CXI9966/RM2025-PowerControlBoard-WirelessCharging/PowerControl_PCM_V0.1_Control/PowerControl_PCM_V0.1_Control.kicad_pcb

## KiCad design PowerControl_PCM_V0.1_Control/PowerControl_PCM_V0.1_Control.kicad_pcb (2026-10-14)

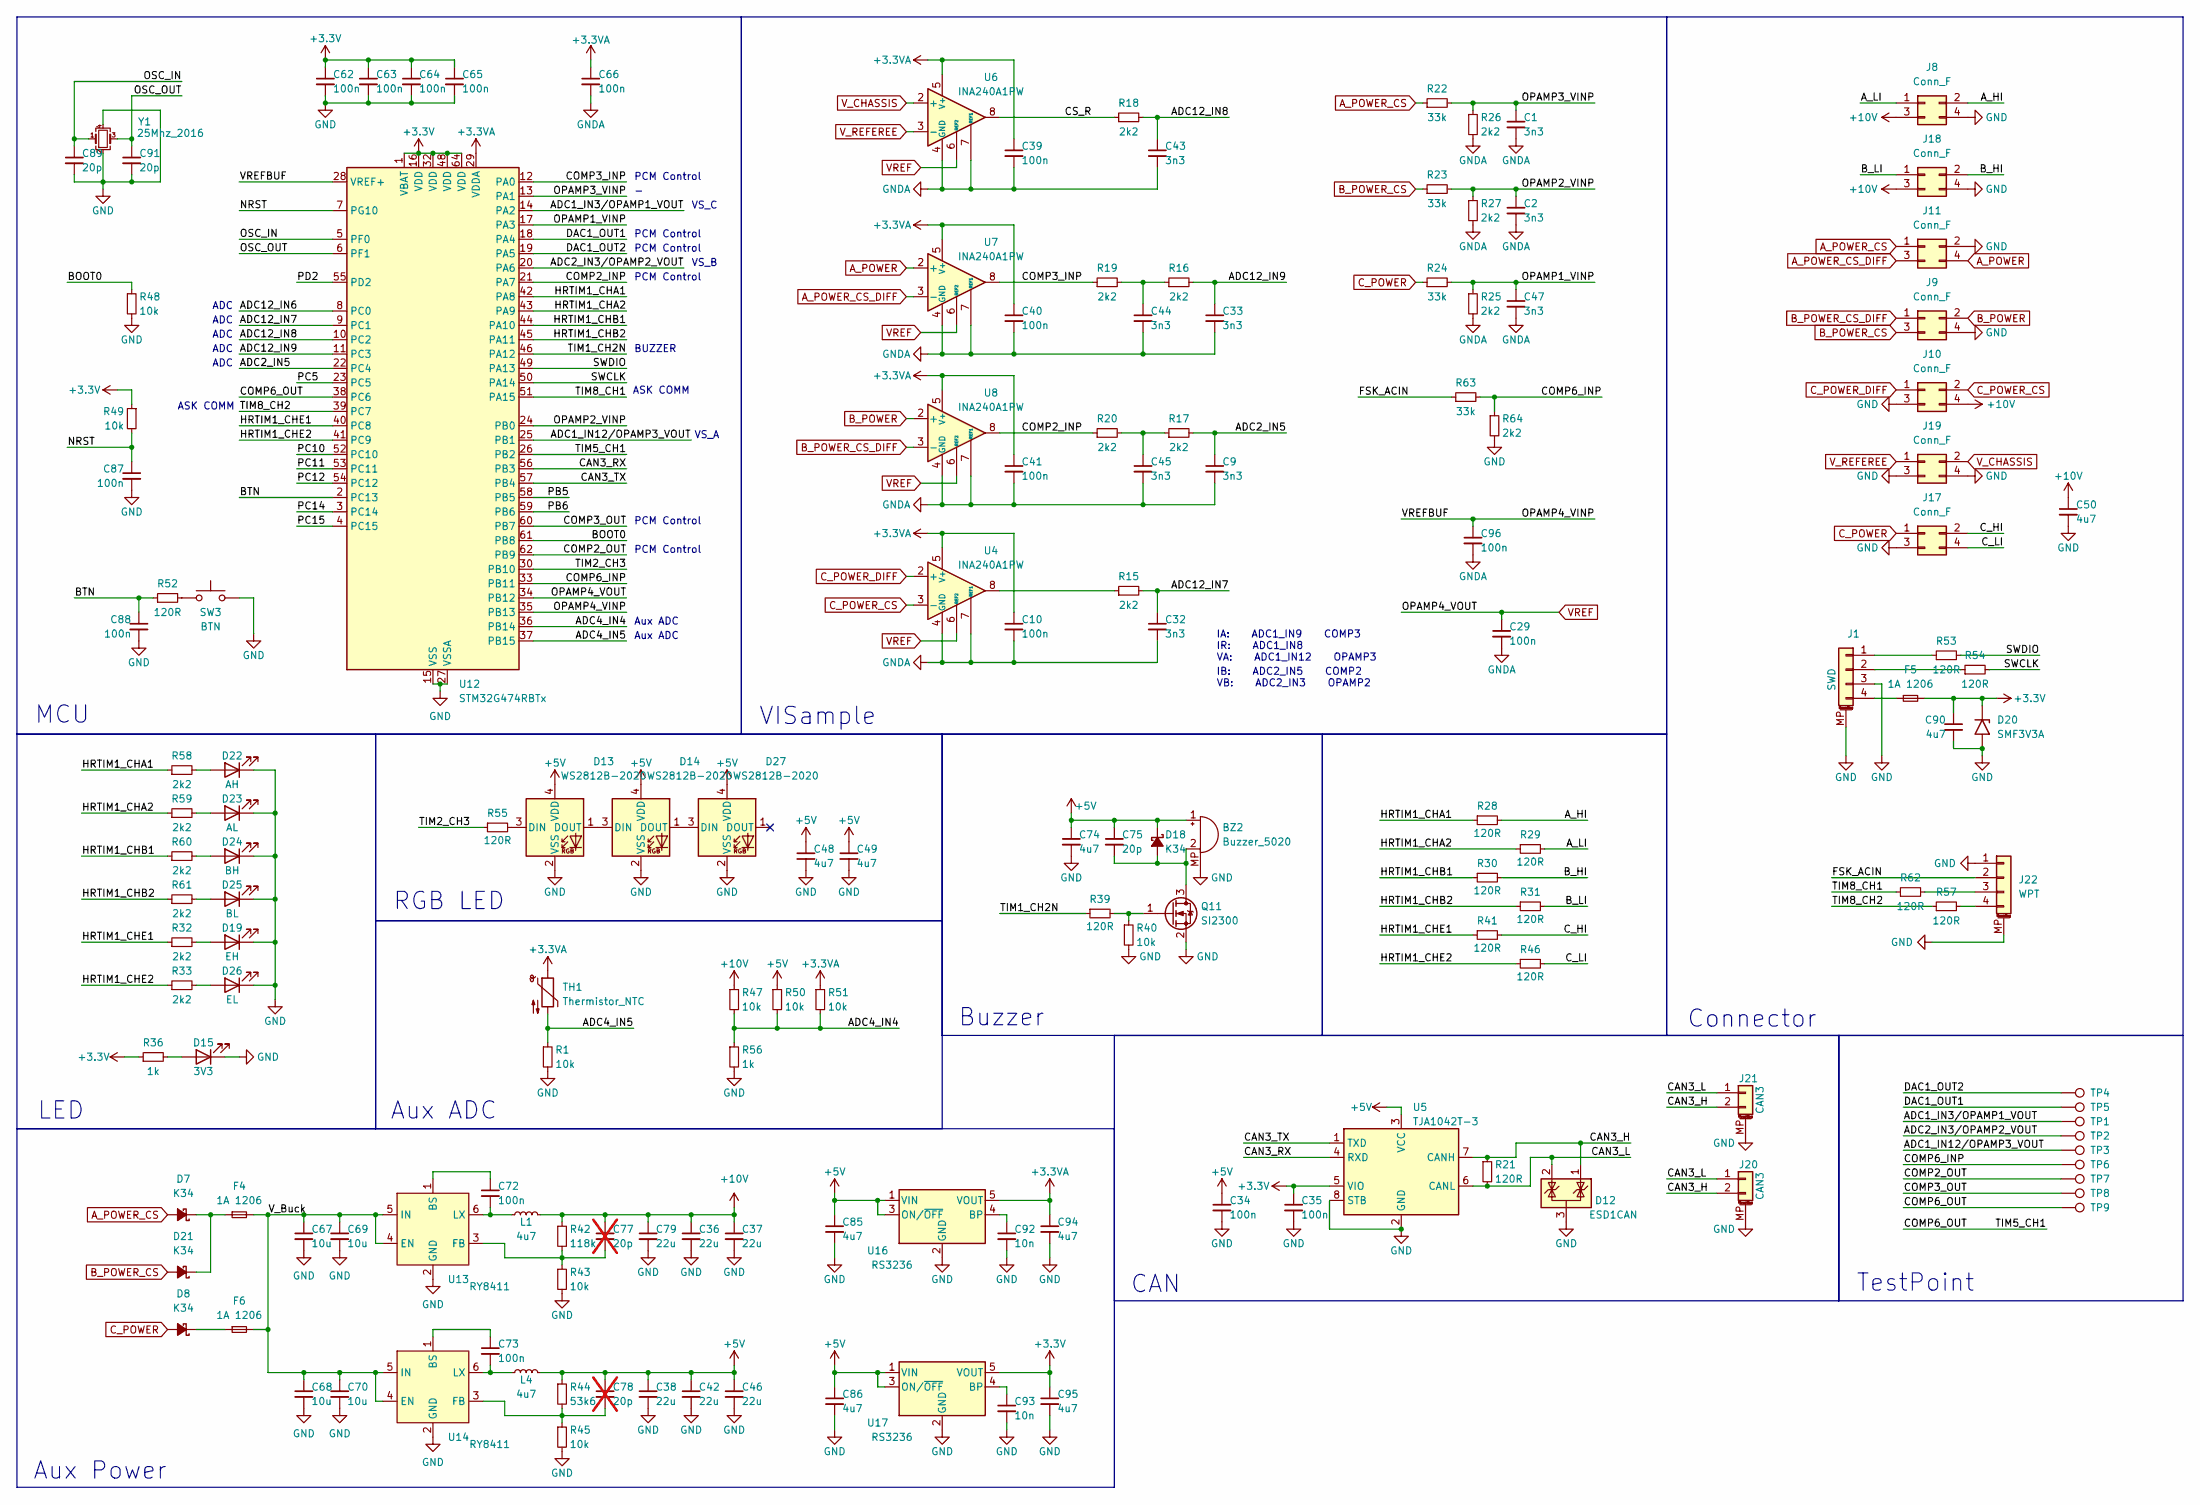
[picture p1: schematic PowerControl_PCM_V0.1_Control.kicad_sch]

Parts:
BZ2: Buzzer_5020
C1, C2, C9, C32, C33, C43, C44, C45, C47: 3n3; C_0603_1608Metric
C10, C29, C34, C35, C39, C40, C41, C62, C63, C64, C65, C66, C72, C73, C87, C88, C96: 100n; C_0603_1608Metric
C36, C37, C38, C42, C46, C79: 22u; C_0805_2012Metric
C48, C49, C50, C74, C85, C86, C90, C94, C95: 4u7; C_0603_1608Metric
C67, C68, C69, C70: 10u; C_1206_3216Metric
C75, C89, C91: 20p; C_0603_1608Metric
C77, C78: 20p; C_0603_1608Metric; not fitted
C92, C93: 10n; C_0603_1608Metric
D7, D8, D18, D21: K34; D_SMF
D12: ESD1CAN; SOT-23
D13, D14, D27: WS2812B-2020
D15: 3V3; LED_0603_1608Metric
D19: EH; LED_0603_1608Metric
D20: SMF3V3A; D_SMF
D22: AH; LED_0603_1608Metric
D23: AL; LED_0603_1608Metric
D24: BH; LED_0603_1608Metric
D25: BL; LED_0603_1608Metric
D26: EL; LED_0603_1608Metric
F4, F5, F6: 1A 1206; Fuse_1206_3216Metric
J1: SWD; Molex_PicoBlade_53261-0471_1x04-1MP_P1.25mm_Horizontal
J8, J9, J10, J11, J17, J18, J19: Conn_F; PinSocket_2x02_P2.00mm
J20, J21: CAN3; JST_GH_BM02B-GHS-TBT_1x02-1MP_P1.25mm_Vertical
J22: WPT; JST_GH_BM04B-GHS-TBT_1x04-1MP_P1.25mm_Vertical
L1, L4: 4u7; L_Sunlord_SWPA3015S
Q11: SI2300; SOT-23
R1, R40, R43, R45, R47, R48, R49, R50, R51: 10k; R_0603_1608Metric
R15, R16, R17, R18, R19, R20, R25, R26, R27, R32, R33, R58, R59, R60, R61, R64: 2k2; R_0603_1608Metric
R21, R28, R29, R30, R31, R39, R41, R46, R52, R53, R54, R55, R57, R62: 120R; R_0603_1608Metric
R22, R23, R24, R63: 33k; R_0603_1608Metric
R36, R56: 1k; R_0603_1608Metric
R42: 118k; R_0603_1608Metric
R44: 53k6; R_0603_1608Metric
SW3: BTN; Button_PTS810
TH1: Thermistor_NTC; R_0603_1608Metric
TP1, TP2, TP3, TP4, TP5, TP6, TP7, TP8, TP9: TestPoint; TestPoint_Pad_D1.0mm
U4, U6, U7, U8: INA240A1PW; TSSOP-8_4.4x3mm_P0.65mm
U5: TJA1042T-3; SOIC-8_3.9x4.9mm_P1.27mm
U12: STM32G474RBTx; LQFP-64_10x10mm_P0.5mm
U13, U14: RY8411; SOT-23-6
U16, U17: RS3236; SOT-23-5
Y1: 25Mhz_2016; Crystal_SMD_2016

Connections:
+3.3V: C35.1, C62.1, C63.1, C64.1, C65.1, C90.1, C95.1, D20.1 (A1), F5.2, R36.1, R49.1, U5.5 (VIO), U12.1 (VBAT), U12.16 (VDD), U12.32 (VDD), U12.48 (VDD), U12.64 (VDD), U17.5 (VOUT)
+3.3VA: C10.1, C39.1, C40.1, C41.1, C66.1, C94.1, R51.1, TH1.1, U4.5 (V+), U6.5 (V+), U7.5 (V+), U8.5 (V+), U12.29 (VDDA), U16.5 (VOUT)
+5V: BZ2.1 (+), C34.1, C38.1, C42.1, C46.1, C48.1, C49.1, C74.1, C75.1, C78.1, C85.1, C86.1, D13.4 (VDD), D14.4 (VDD), D18.1 (K), D27.4 (VDD), L4.2, R44.1, R50.1, U5.3 (VCC), U16.1 (VIN), U16.3 (ON/~OFF), U17.1 (VIN), U17.3 (ON/~OFF)
+10V: C36.1, C37.1, C50.1, C77.1, C79.1, J8.3, J10.4, J18.3, L1.2, R42.1, R47.1
/ADC1_IN3/OPAMP1_VOUT: TP1.1, U12.14 (PA2)
/ADC1_IN12/OPAMP3_VOUT: TP3.1, U12.25 (PB1)
/ADC2_IN3/OPAMP2_VOUT: TP2.1, U12.20 (PA6)
/ADC2_IN5: C9.1, R17.2, U12.22 (PC4)
/ADC4_IN4: R47.2, R50.2, R51.2, R56.1, U12.36 (PB14)
/ADC4_IN5: R1.1, TH1.2, U12.37 (PB15)
/ADC12_IN6: U12.8 (PC0)
/ADC12_IN7: C32.1, R15.2, U12.9 (PC1)
/ADC12_IN8: C43.1, R18.2, U12.10 (PC2)
/ADC12_IN9: C33.1, R16.2, U12.11 (PC3)
/A_HI: J8.2, R28.2
/A_LI: J8.1, R29.2
/BOOT0: R48.1, U12.61 (PB8)
/BTN: C88.1, R52.1, U12.2 (PC13)
/B_HI: J18.2, R30.2
/B_LI: J18.1, R31.2
/CAN3_H: D12.1 (K), J20.2, J21.2, R21.1, U5.7 (CANH)
/CAN3_L: D12.2 (K), J20.1, J21.1, R21.2, U5.6 (CANL)
/CAN3_RX: U5.4 (RXD), U12.56 (PB3)
/CAN3_TX: U5.1 (TXD), U12.57 (PB4)
/COMP2_INP: R20.1, U8.8, U12.21 (PA7)
/COMP2_OUT: TP7.1, U12.62 (PB9)
/COMP3_INP: R19.1, U7.8, U12.12 (PA0)
/COMP3_OUT: TP8.1, U12.60 (PB7)
/COMP6_INP: R63.2, R64.1, TP6.1, U12.33 (PB11)
/COMP6_OUT: TP9.1, U12.26 (PB2), U12.38 (PC6)
/CS_R: R18.1, U6.8
/C_HI: J17.2, R41.2
/C_LI: J17.4, R46.2
/DAC1_OUT1: TP5.1, U12.18 (PA4)
/DAC1_OUT2: TP4.1, U12.19 (PA5)
/FSK_ACIN: J22.2, R63.1
/HRTIM1_CHA1: R28.1, R58.1, U12.42 (PA8)
/HRTIM1_CHA2: R29.1, R59.1, U12.43 (PA9)
/HRTIM1_CHB1: R30.1, R60.1, U12.44 (PA10)
/HRTIM1_CHB2: R31.1, R61.1, U12.45 (PA11)
/HRTIM1_CHE1: R32.1, R41.1, U12.40 (PC8)
/HRTIM1_CHE2: R33.1, R46.1, U12.41 (PC9)
/NRST: C87.1, R49.2, U12.7 (PG10)
/OPAMP1_VINP: C47.1, R24.2, R25.1, U12.17 (PA3)
/OPAMP2_VINP: C2.1, R23.2, R27.1, U12.24 (PB0)
/OPAMP3_VINP: C1.1, R22.2, R26.1, U12.13 (PA1)
/OPAMP4_VINP: C96.1, U12.28 (VREF+), U12.35 (PB13)
/OSC_IN: C89.1, U12.5 (PF0), Y1.1
/OSC_OUT: C91.1, U12.6 (PF1), Y1.3
/PB5: U12.58 (PB5)
/PB6: U12.59 (PB6)
/PC5: U12.23 (PC5)
/PC10: U12.52 (PC10)
/PC11: U12.53 (PC11)
/PC12: U12.54 (PC12)
/PC14: U12.3 (PC14)
/PC15: U12.4 (PC15)
/PD2: U12.55 (PD2)
/SWCLK: R54.2, U12.50 (PA14)
/SWDIO: R53.2, U12.49 (PA13)
/TIM1_CH2N: R39.1, U12.46 (PA12)
/TIM2_CH3: R55.1, U12.30 (PB10)
/TIM8_CH1: R62.1, U12.51 (PA15)
/TIM8_CH2: R57.1, U12.39 (PC7)
/V_Buck: C67.1, C68.1, C69.1, C70.1, F4.2, F6.2, U13.4 (EN), U13.5 (IN), U14.4 (EN), U14.5 (IN)
A_POWER: J11.4, U7.2 (+)
A_POWER_CS: D7.2 (A), J11.1, R22.1
A_POWER_CS_DIFF: J11.3, U7.3 (-)
B_POWER: J9.2, U8.2 (+)
B_POWER_CS: D21.2 (A), J9.3, R23.1
B_POWER_CS_DIFF: J9.1, U8.3 (-)
C_POWER: D8.2 (A), J17.1, R24.1
C_POWER_CS: J10.2, U4.3 (-)
C_POWER_DIFF: J10.1, U4.2 (+)
GND: BZ2.MP, C34.2, C35.2, C36.2, C37.2, C38.2, C42.2, C46.2, C48.2, C49.2, C50.2, C62.2, C63.2, C64.2, C65.2, C67.2, C68.2, C69.2, C70.2, C74.2, C79.2, C85.2, C86.2, C87.2, C88.2, C89.2, C90.2, C91.2, C92.2, C93.2, C94.2, C95.2, D12.3 (A), D13.2 (VSS), D14.2 (VSS), D15.1 (K), D19.1 (K), D20.2 (A2), D22.1 (K), D23.1 (K), D24.1 (K), D25.1 (K), D26.1 (K), D27.2 (VSS), J1.3, J1.MP (MountPin), J8.4, J9.4, J10.3, J11.2, J17.3, J18.4, J19.3, J19.4, J20.MP (MountPin), J21.MP (MountPin), J22.1, J22.MP (MountPin), Q11.2 (S), R1.2, R40.2, R43.2, R45.2, R48.2, R56.2, R64.2, SW3.2, U5.2 (GND), U5.8 (STB), U12.15 (VSS), U12.27 (VSSA), U12.31 (VSS), U12.47 (VSS), U12.63 (VSS), U13.2 (GND), U14.2 (GND), U16.2 (GND), U17.2 (GND), Y1.2, Y1.4
GNDA: C1.2, C2.2, C9.2, C10.2, C29.2, C32.2, C33.2, C39.2, C40.2, C41.2, C43.2, C44.2, C45.2, C47.2, C66.2, C96.2, R25.2, R26.2, R27.2, U4.1 (GND), U4.4 (GND), U4.7 (REF1), U6.1 (GND), U6.4 (GND), U6.7 (REF1), U7.1 (GND), U7.4 (GND), U7.7 (REF1), U8.1 (GND), U8.4 (GND), U8.7 (REF1)
unnamed: BZ2.2 (-), C75.2, D18.2 (A), Q11.3 (D)
unnamed: C44.1, R16.1, R19.2
unnamed: C45.1, R17.1, R20.2
unnamed: D8.1 (K), F6.1
unnamed: D13.3 (DIN), R55.2
unnamed: D13.1 (DOUT), D14.3 (DIN)
unnamed: D14.1 (DOUT), D27.3 (DIN)
unnamed: D15.2 (A), R36.2
unnamed: D19.2 (A), R32.2
unnamed: D7.1 (K), D21.1 (K), F4.1
unnamed: D22.2 (A), R58.2
unnamed: D23.2 (A), R59.2
unnamed: D24.2 (A), R60.2
unnamed: D25.2 (A), R61.2
unnamed: D26.2 (A), R33.2
unnamed: J1.1, R53.1
unnamed: J1.2, R54.1
unnamed: F5.1, J1.4
unnamed: J22.3, R62.2
unnamed: J22.4, R57.2
unnamed: Q11.1 (G), R39.2, R40.1
unnamed: R15.1, U4.8
unnamed: R52.2, SW3.1
unnamed: C72.1, U13.1 (BS)
unnamed: C77.2, R42.2, R43.1, U13.3 (FB)
unnamed: C72.2, L1.1, U13.6 (LX)
unnamed: C73.1, U14.1 (BS)
unnamed: C78.2, R44.2, R45.1, U14.3 (FB)
unnamed: C73.2, L4.1, U14.6 (LX)
unnamed: C92.1, U16.4 (BP)
unnamed: C93.1, U17.4 (BP)
VREF: C29.1, U4.6 (REF2), U6.6 (REF2), U7.6 (REF2), U8.6 (REF2), U12.34 (PB12)
V_CHASSIS: J19.2, U6.2 (+)
V_REFEREE: J19.1, U6.3 (-)

Notes on the sheet:
Aux ADC
VS_A
ADC
IA: ADC1_IN9 COMP3 IR: ADC1_IN8 VA: ADC1_IN12 OPAMP3
PCM Control
Buzzer
TestPoint
CAN
Connector
VS_C
BUZZER
VISample
IB: ADC2_IN5 COMP2 VB: ADC2_IN3 OPAMP2
ASK COMM
LED
RGB LED
Aux Power
VS_B
MCU

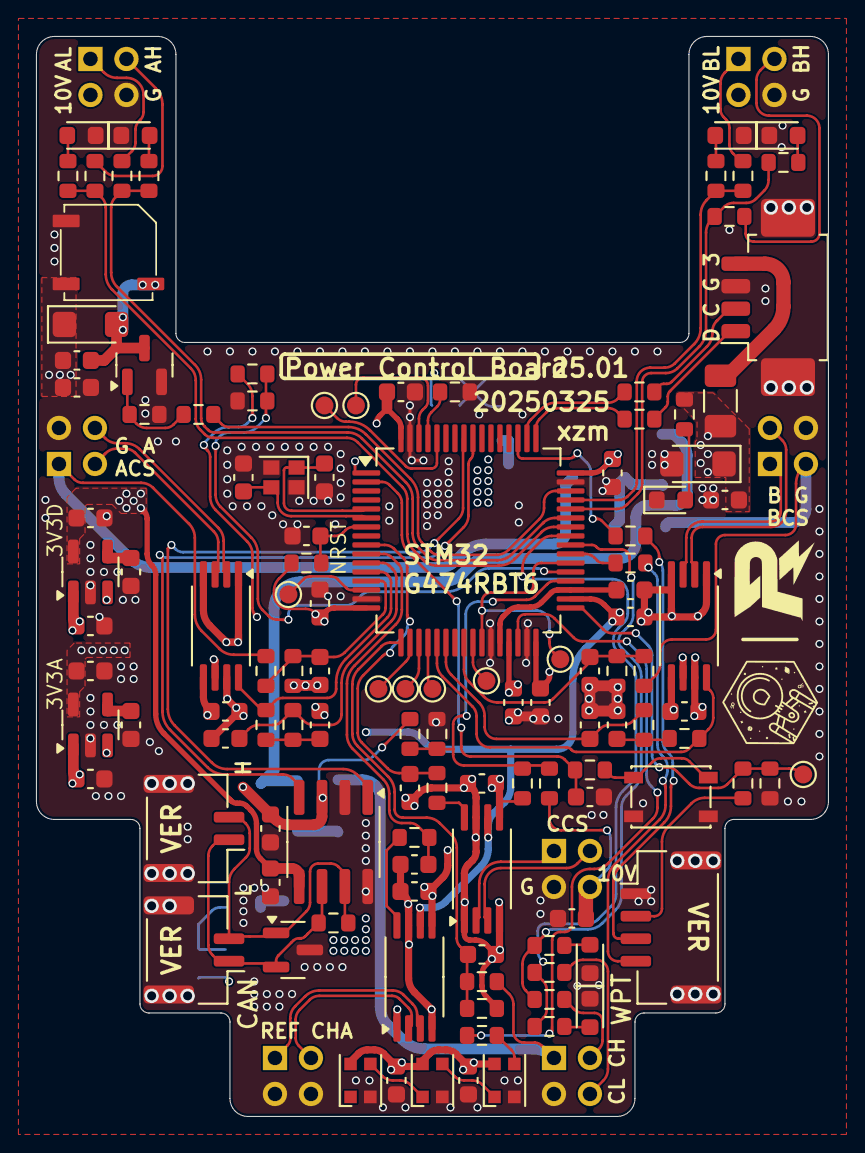
[picture p2: board PowerControl_PCM_V0.1_Control.kicad_pcb from above]

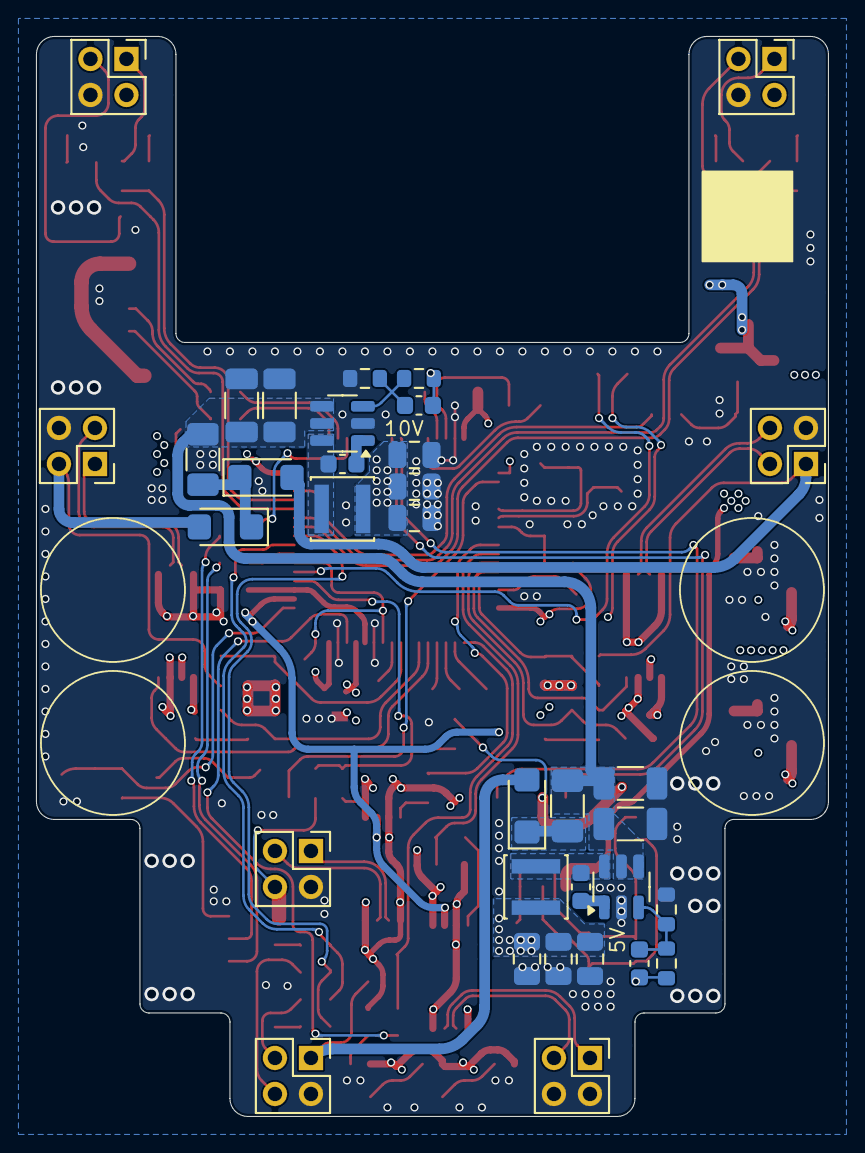
[picture p3: board PowerControl_PCM_V0.1_Control.kicad_pcb from below]

Board: 4 copper layers, 44.0 x 60.0 mm, 155 parts (34 on the bottom side), 100 nets.
