CXI9966/RM2025-PowerControlBoard-WirelessCharging/PowerControl_PCM_V0.1_Power/PowerControl_PCM_V0.1_Power.kicad_pcb

## KiCad design PowerControl_PCM_V0.1_Power/PowerControl_PCM_V0.1_Power.kicad_pcb (2026-10-14)

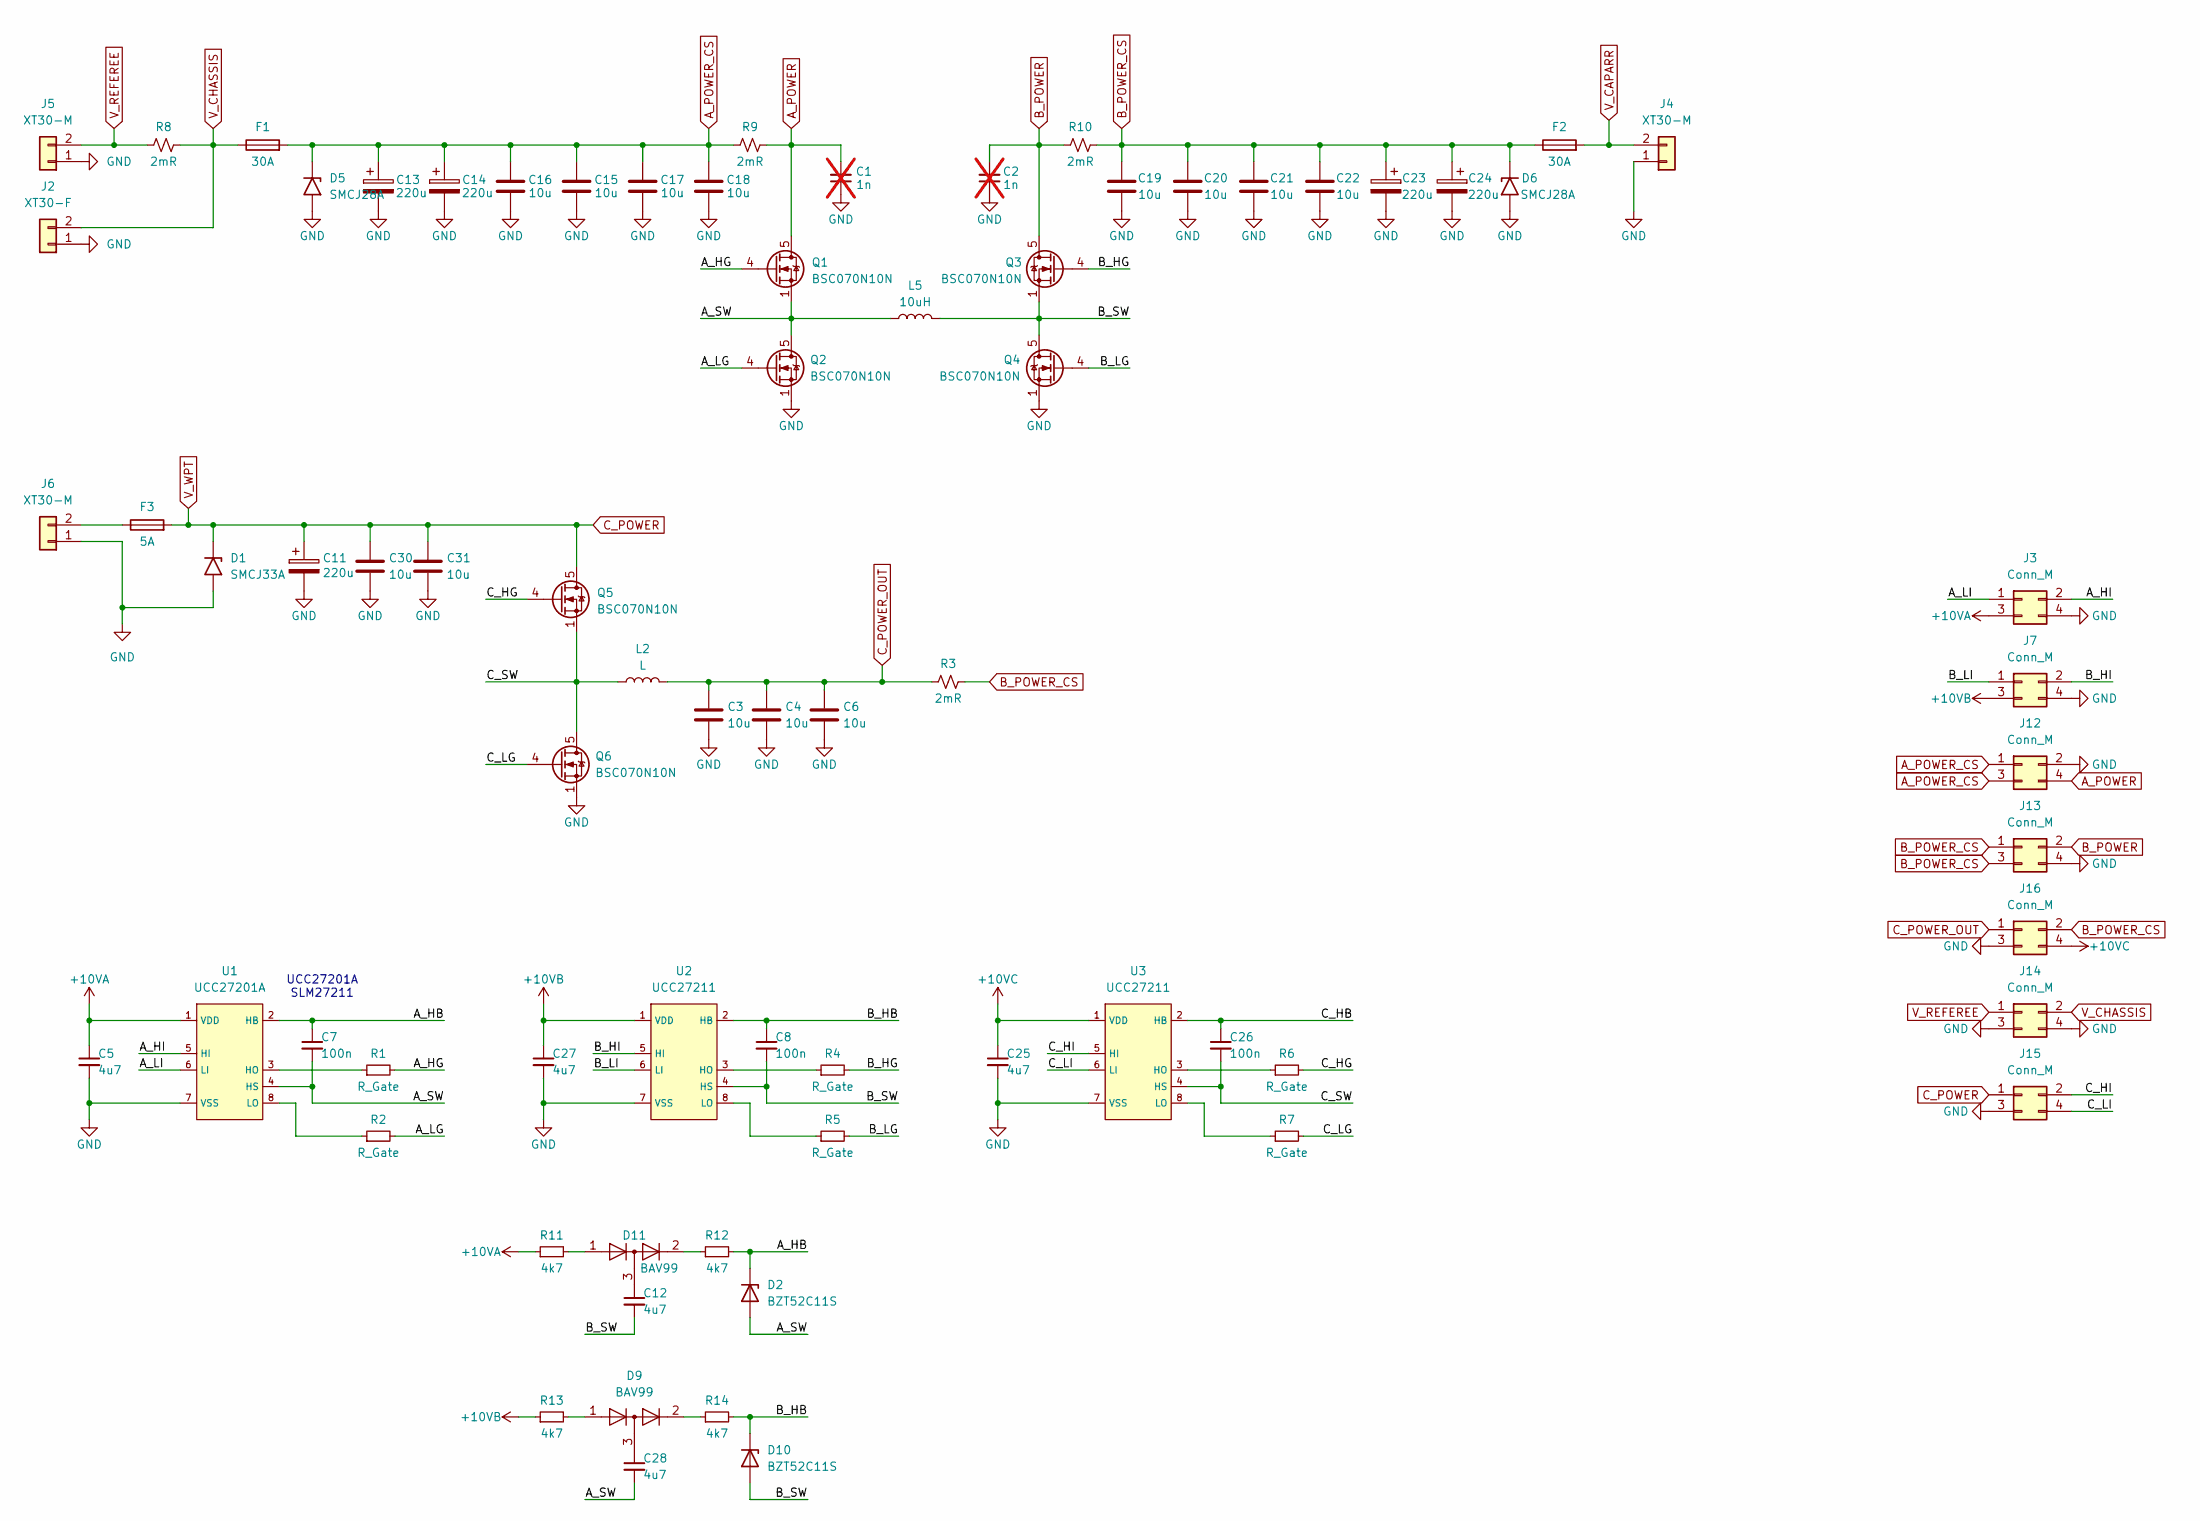
[picture p4: schematic PowerControl_PCM_V0.1_Power.kicad_sch]

Parts:
C1, C2: 1n; C_0603_1608Metric; not fitted
C3, C4, C6, C15, C16, C17, C18, C19, C20, C21, C22, C30, C31: 10u; C_1206_3216Metric
C5, C12, C25, C27, C28: 4u7; C_0603_1608Metric
C7, C8, C26: 100n; C_0603_1608Metric
C11, C13, C14, C23, C24: 220u; C_D8.0mm_P3.50mm
D1: SMCJ33A; D_SMC
D2, D10: BZT52C11S; D_SOD-323_HandSoldering
D5, D6: SMCJ28A; D_SMC
D9, D11: BAV99; SOT-23
F1, F2: 30A; Fuse_Littelfuse-NANO2-451_453
F3: 5A; Fuse_Littelfuse-NANO2-451_453
J2: XT30-F; AMASS_XT30U-F_1x02_P5.0mm_Vertical
J3, J7, J12, J13, J14, J15, J16: Conn_M; PinHeader_2x02_P2.00mm_Vertical_SMD
J4, J5, J6: XT30-M; AMASS_XT30U-M_1x02_P5.0mm_Vertical
L2: L; L_Wuerth_HCI-1040
L5: 10uH; L_VER2923
Q1, Q2, Q3, Q4, Q5, Q6: BSC070N10N; TDSON-8-1
R1, R2, R4, R5, R6, R7: R_Gate; R_0603_1608Metric
R3, R8, R9, R10: 2mR; R_2512_6332Metric
R11, R12, R13, R14: 4k7; R_0603_1608Metric
U1: UCC27201A; SOIC-8_3.9x4.9mm_P1.27mm
U2, U3: UCC27211; SOIC-8_3.9x4.9mm_P1.27mm

Connections:
+10VA: C5.1, J3.3, R11.1, U1.1 (VDD)
+10VB: C27.1, J7.3, R13.1, U2.1 (VDD)
+10VC: C25.1, J16.4, U3.1 (VDD)
/A_HB: C7.1, D2.1 (K), R12.2, U1.2 (HB)
/A_HG: Q1.4 (G), R1.2
/A_HI: J3.2, U1.5 (HI)
/A_LG: Q2.4 (G), R2.2
/A_LI: J3.1, U1.6 (LI)
/A_SW: C7.2, C28.2, D2.2 (A), L5.1, Q1.1 (S), Q1.2 (S), Q1.3 (S), Q2.5 (D), U1.4 (HS)
/B_HB: C8.1, D10.1 (K), R14.2, U2.2 (HB)
/B_HG: Q3.4 (G), R4.2
/B_HI: J7.2, U2.5 (HI)
/B_LG: Q4.4 (G), R5.2
/B_LI: J7.1, U2.6 (LI)
/B_SW: C8.2, C12.2, D10.2 (A), L5.2, Q3.1 (S), Q3.2 (S), Q3.3 (S), Q4.5 (D), U2.4 (HS)
/C_HB: C26.1, U3.2 (HB)
/C_HG: Q5.4 (G), R6.2
/C_HI: J15.2, U3.5 (HI)
/C_LG: Q6.4 (G), R7.2
/C_LI: J15.4, U3.6 (LI)
/C_SW: C26.2, L2.1, Q5.1 (S), Q5.2 (S), Q5.3 (S), Q6.5 (D), U3.4 (HS)
A_POWER: C1.2, J12.4, Q1.5 (D), R9.2
A_POWER_CS: C13.1, C14.1, C15.2, C16.2, C17.2, C18.2, D5.1 (A1), F1.2, J12.1, J12.3, R9.1
B_POWER: C2.2, J13.2, Q3.5 (D), R10.1
B_POWER_CS: C19.2, C20.2, C21.2, C22.2, C23.1, C24.1, D6.1 (A1), F2.1, J13.1, J13.3, J16.2, R3.2, R10.2
C_POWER: C11.1, C30.1, C31.1, D1.1 (A1), F3.2, J15.1, Q5.5 (D)
C_POWER_OUT: C3.1, C4.1, C6.1, J16.1, L2.2, R3.1
GND: C1.1, C2.1, C3.2, C4.2, C5.2, C6.2, C11.2, C13.2, C14.2, C15.1, C16.1, C17.1, C18.1, C19.1, C20.1, C21.1, C22.1, C23.2, C24.2, C25.2, C27.2, C30.2, C31.2, D1.2 (A2), D5.2 (A2), D6.2 (A2), J2.1, J3.4, J4.1, J5.1, J6.1, J7.4, J12.2, J13.4, J14.3, J14.4, J15.3, J16.3, Q2.1 (S), Q2.2 (S), Q2.3 (S), Q4.1 (S), Q4.2 (S), Q4.3 (S), Q6.1 (S), Q6.2 (S), Q6.3 (S), U1.7 (VSS), U2.7 (VSS), U3.7 (VSS)
unnamed: C12.1, D11.3 (K)
unnamed: C28.1, D9.3 (K)
unnamed: D9.2 (A), R14.1
unnamed: D9.1 (K), R13.2
unnamed: D11.2 (A), R12.1
unnamed: D11.1 (K), R11.2
unnamed: F3.1, J6.2
unnamed: R1.1, U1.3 (HO)
unnamed: R2.1, U1.8 (LO)
unnamed: R4.1, U2.3 (HO)
unnamed: R5.1, U2.8 (LO)
unnamed: R6.1, U3.3 (HO)
unnamed: R7.1, U3.8 (LO)
V_CAPARR: F2.2, J4.2
V_CHASSIS: F1.1, J2.2, J14.2, R8.2
V_REFEREE: J5.2, J14.1, R8.1

Notes on the sheet:
UCC27201A SLM27211

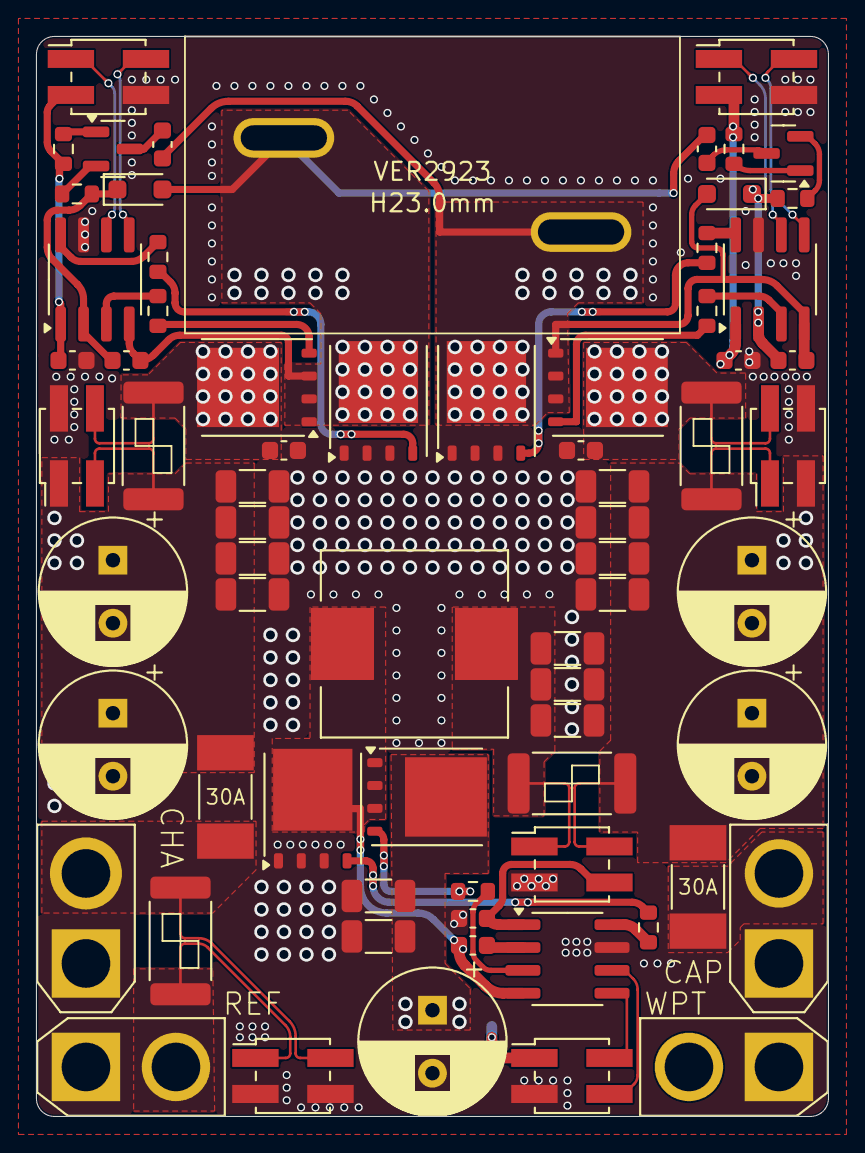
[picture p5: board PowerControl_PCM_V0.1_Power.kicad_pcb from above]

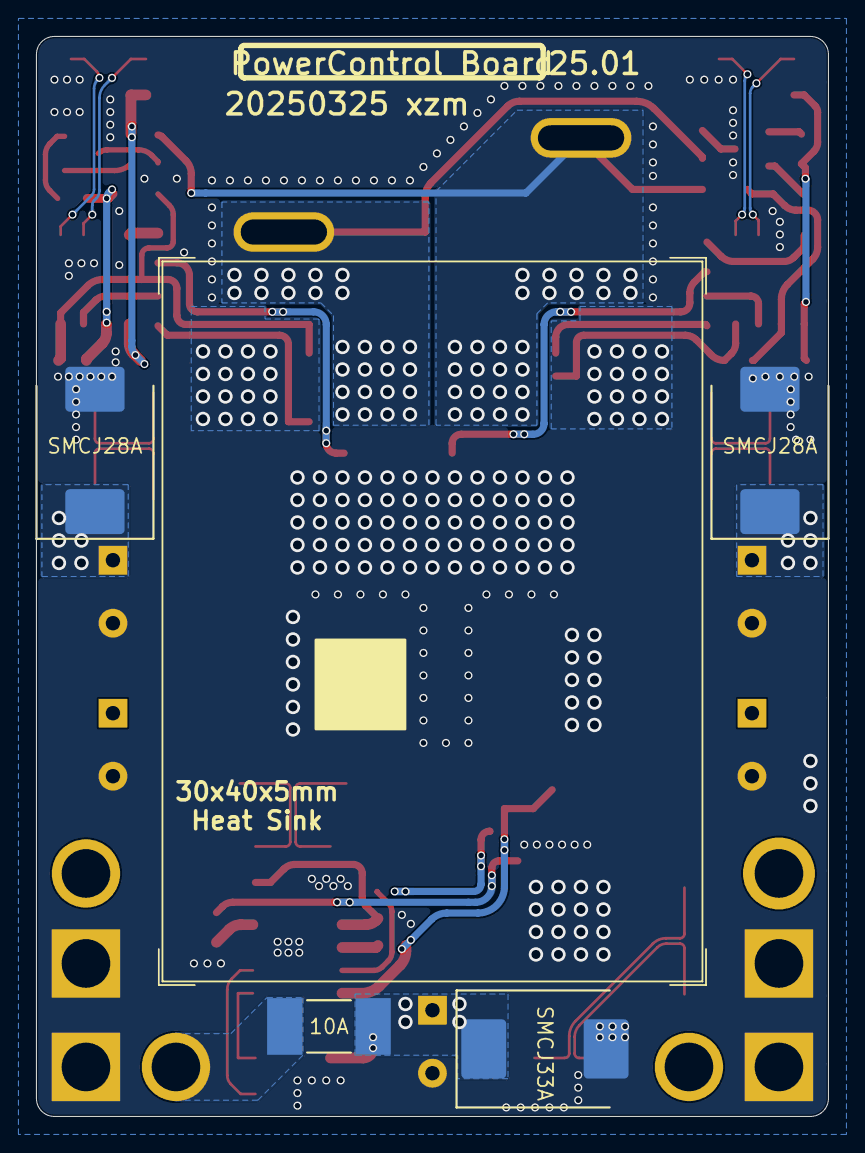
[picture p6: board PowerControl_PCM_V0.1_Power.kicad_pcb from below]

Board: 2 copper layers, 44.0 x 60.0 mm, 74 parts (4 on the bottom side), 44 nets.
