CXI9966/RM2025-PowerControlBoard-WirelessCharging/PowerControlBoard_Software_FieldVersion/Core/Inc/Calibration.hpp

#pragma once
#include "main.h"
//#include "PowerManager.hpp"
//#include "Config.hpp"

#define HARDWARE_ID 502

// CAN standard identifiers used by the field-version protocol.
#define CAN_CMD_ID             0x161U
#define CAN_FEEDBACK_ID        0x151U
#define CAN_FEEDBACK_NEW_ID    0x152U


#ifndef HARDWARE_ID
#error "please specify hardware id"
#endif


//#define WPT_HARDWARE
#define CALIBRATION_MODE
//#define IGNORE_CAPACITOR_ERROR

#ifndef CALIBRATION_MODE




#define HARDWARE_UID_W0 0x03473487
#define HARDWARE_UID_W1 0x1397444617
#define HARDWARE_UID_W2 0x540292914


#define ADC_VA_K        0.00284025493302185f
#define ADC_VA_B        0.096382087f
#define ADC_VB_K        0.00283064245539459f
#define ADC_VB_B        0.096382087f

#define ADC_IA_K        -0.00426032707865977f
#define ADC_IA_B        34.6220566648572f
#define ADC_IB_K        0.00436961348441836f
#define ADC_IB_B        -35.442372697575f

#define ADC_IREF_K      0.00438520650402692f
#define ADC_IREF_B      -35.6851326479174f

#define WPT_HARDWARE
#define ADC_VWPT_K      0.00282862236057022f
#define ADC_VWPT_B      0.126888445762173f
#define ADC_IWPT_K      0.00421074805006724f
#define ADC_IWPT_B      -34.2917170449864f

#elif (HARDWARE_ID == 501) //备用

#define HARDWARE_UID_W0     0x00540049
#define HARDWARE_UID_W1     0x534B5008
#define HARDWARE_UID_W2     0x20343732

#define ADC_VA_K        0.0027260742967763f
#define ADC_VA_B        0.5167775143107710f
#define ADC_VB_K        0.0027839114676537f
#define ADC_VB_B        0.1233551070156690f

#define ADC_IA_K        -0.00426032707865977f
#define ADC_IA_B        34.6220566648572f
#define ADC_IB_K        0.00436961348441836f
#define ADC_IB_B        -35.442372697575f

#define ADC_IREF_K      0.00438520650402692f
#define ADC_IREF_B      -35.6851326479174f

#define WPT_HARDWARE
#define ADC_VWPT_K      0.00282862236057022f
#define ADC_VWPT_B      0.126888445762173f
#define ADC_IWPT_K      0.00421074805006724f
#define ADC_IWPT_B      -34.2917170449864f


#elif (HARDWARE_ID == 502) //备用

#define HARDWARE_UID_W0     0x00550045
#define HARDWARE_UID_W1     0x534B5008
#define HARDWARE_UID_W2     0x20343732

#define ADC_VA_K        0.0027239318140675f
#define ADC_VA_B        0.3552299834552710f
#define ADC_VB_K        0.0027930288554394f
#define ADC_VB_B        0.0890119136534544f

#define ADC_IA_K        -0.00426032707865977f
#define ADC_IA_B        34.6220566648572f
#define ADC_IB_K        0.00436961348441836f
#define ADC_IB_B        -35.442372697575f

#define ADC_IREF_K      0.00438520650402692f
#define ADC_IREF_B      -35.6851326479174f

#define WPT_HARDWARE
#define ADC_VWPT_K      0.0027699952827981f
#define ADC_VWPT_B      0.0915677729711426f
#define ADC_IWPT_K      0.00421074805006724f
#define ADC_IWPT_B      -34.1917170449864f


#elif (HARDWARE_ID == 503) 

#define HARDWARE_UID_W0     0x00540047
#define HARDWARE_UID_W1     0x534B5008
#define HARDWARE_UID_W2     0x20343732

#define ADC_VA_K        0.0028255684147110f
#define ADC_VA_B        0.0660700075102127f
#define ADC_VB_K        0.0028423113464348f
#define ADC_VB_B        0.0901576051061248f

#define ADC_IA_K        -0.00426032707865977f
#define ADC_IA_B        34.6220566648572f
#define ADC_IB_K        0.00436961348441836f
#define ADC_IB_B        -35.442372697575f

#define ADC_IREF_K      0.00438520650402692f
#define ADC_IREF_B      -35.6851326479174f

#define WPT_HARDWARE
#define ADC_VWPT_K      0.0027579227033994f
#define ADC_VWPT_B      0.0733421803892185f
#define ADC_IWPT_K      0.00421074805006724f
#define ADC_IWPT_B      -34.2917170449864f


#elif (HARDWARE_ID == 504) //英雄

#define HARDWARE_UID_W0     0x00550046
#define HARDWARE_UID_W1     0x534B5008
#define HARDWARE_UID_W2     0x20343732

#define ADC_VA_K        0.0027282881375574f
#define ADC_VA_B        0.1831615104370490f
#define ADC_VB_K        0.0028300840292121f
#define ADC_VB_B        0.1077536795506190f

#define ADC_IA_K        -0.00426032707865977f
#define ADC_IA_B        34.6220566648572f
#define ADC_IB_K        0.00436961348441836f
#define ADC_IB_B        -35.442372697575f

#define ADC_IREF_K      0.00438520650402692f
#define ADC_IREF_B      -35.6851326479174f

#define WPT_HARDWARE
#define ADC_VWPT_K      0.0028197687167123f
#define ADC_VWPT_B      0.0609614634376214f
#define ADC_IWPT_K      0.00421074805006724f
#define ADC_IWPT_B      -34.2917170449864f


#elif (HARDWARE_ID == 505) //备用

#define HARDWARE_UID_W0     0x001B0037
#define HARDWARE_UID_W1     0x31365010
#define HARDWARE_UID_W2     0x2035384D

#define ADC_VA_K        0.0027734789141005f
#define ADC_VA_B        0.0927763511337112f
#define ADC_VB_K        0.0028365236221268f
#define ADC_VB_B        0.0812055915390602f

#define ADC_IA_K        -0.00426032707865977f
#define ADC_IA_B        34.6220566648572f
#define ADC_IB_K        0.00436961348441836f
#define ADC_IB_B        -35.442372697575f

#define ADC_IREF_K      0.00438520650402692f
#define ADC_IREF_B      -35.6851326479174f

#define WPT_HARDWARE
#define ADC_VWPT_K      0.0028256477659557f
#define ADC_VWPT_B      0.0641163842218795f
#define ADC_IWPT_K      0.00421074805006724f
#define ADC_IWPT_B      -34.2917170449864f


#elif (HARDWARE_ID == 506) //备用

#define HARDWARE_UID_W0     0x001B002B
#define HARDWARE_UID_W1     0x31365010
#define HARDWARE_UID_W2     0x2035384D

#define ADC_VA_K        0.0028196592091020f
#define ADC_VA_B        0.0926029190696198f
#define ADC_VB_K        0.0028303117276925f
#define ADC_VB_B        0.0869209878046959f

#define ADC_IA_K        -0.00426032707865977f
#define ADC_IA_B        34.6220566648572f
#define ADC_IB_K        0.00436961348441836f
#define ADC_IB_B        -35.442372697575f

#define ADC_IREF_K      0.00438520650402692f
#define ADC_IREF_B      -35.6851326479174f

#define WPT_HARDWARE
#define ADC_VWPT_K      0.0028368950138764f
#define ADC_VWPT_B      0.0808307308422300f
#define ADC_IWPT_K      0.00421074805006724f
#define ADC_IWPT_B      -34.2917170449864f

#elif (HARDWARE_ID == 507) //哨兵

#define HARDWARE_UID_W0     0x001B003F
#define HARDWARE_UID_W1     0x31365010
#define HARDWARE_UID_W2     0x2035384D

#define ADC_VA_K        0.0028280222555144f
#define ADC_VA_B        0.0846544037791155f
#define ADC_VB_K        0.0028143006818382f
#define ADC_VB_B        0.1258158876813940f

#define ADC_IA_K        -0.00426032707865977f
#define ADC_IA_B        34.6220566648572f
#define ADC_IB_K        0.00436961348441836f
#define ADC_IB_B        -35.442372697575f

#define ADC_IREF_K      0.00438520650402692f
#define ADC_IREF_B      -35.6851326479174f

#define WPT_HARDWARE
#define ADC_VWPT_K      0.0028233716502915f
#define ADC_VWPT_B      0.0802277571654137f
#define ADC_IWPT_K      0.00421074805006724f
#define ADC_IWPT_B      -34.2917170449864f

#elif (HARDWARE_ID == 508) // 备件

#define HARDWARE_UID_W0     4456519
#define HARDWARE_UID_W1     1496403977
#define HARDWARE_UID_W2     540160840

#define ADC_VA_K       0.00284025493302185f
#define ADC_VA_B       0.082882087f
#define ADC_VB_K       0.00283064245539459f
#define ADC_VB_B       0.106682087f

#define ADC_IA_K       -0.00426032707865977f
#define ADC_IA_B       34.4220566648572f
#define ADC_IB_K       0.00436961348441836f
#define ADC_IB_B       -35.442372697575f

#define ADC_IREF_K      0.00438729036198406f
#define ADC_IREF_B      -35.7106761793126f

// #define WPT_HARDWARE
#define ADC_VWPT_K      0.00282847471852994f
#define ADC_VWPT_B      0.101343129688427f
#define ADC_IWPT_K      0.00421074805006724f
#define ADC_IWPT_B      -34.3397170449864f

#elif (HARDWARE_ID == 509) // 备件

#define HARDWARE_UID_W0     0x003F003F
#define HARDWARE_UID_W1     0x31365010
#define HARDWARE_UID_W2     0x2035384D

#define ADC_VA_K        0.00285648293028194f
#define ADC_VA_B        0.105160621329492f
#define ADC_VB_K        0.0028677485474414f
#define ADC_VB_B        0.104628167159493f

#define ADC_IA_K        -0.00442591938778346f
#define ADC_IA_B        35.9746595967854f
#define ADC_IB_K        0.00443954243767679f
#define ADC_IB_B        -36.0205507032883f

#define ADC_IREF_K      0.00441294349529363f
#define ADC_IREF_B      -35.8819360104446f

#define WPT_HARDWARE
#define ADC_VWPT_K      0.00284706000781405f
#define ADC_VWPT_B      0.102342287644209f
#define ADC_IWPT_K      0.00441294349529363f//
#define ADC_IWPT_B      -35.9317170449864f//

#endif
